sophiayduan/fallout-badges/hardware/3dmodels/2_7inch_e-paper_hat_asm.stp

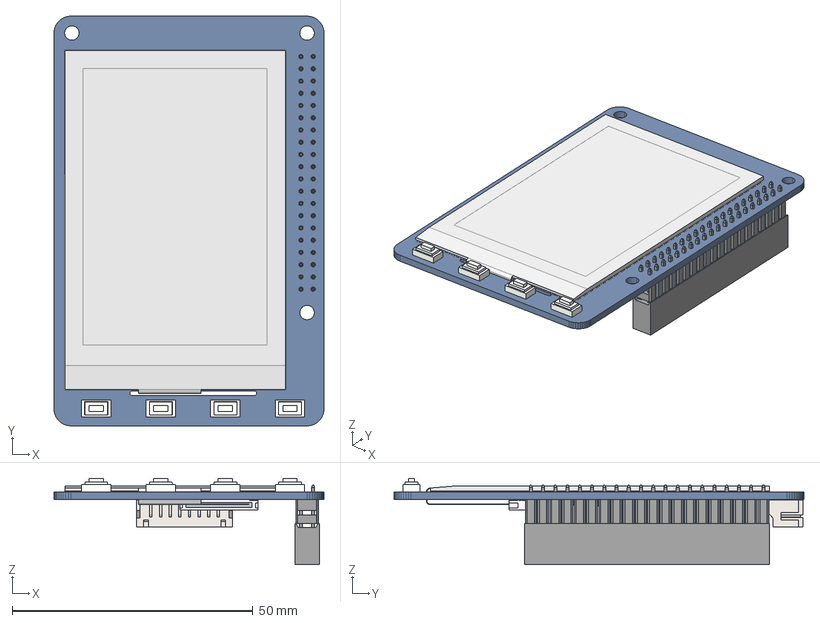
[picture p1: CAD file, 2026-06-06]
hardware/3dmodels/2_7inch_e-paper_hat_asm.stp
56.0 x 85.0 x 17.9 mm
2_7INCH-E_PAPER
BOARD
RESC1608_0603_ x 9
EXTRUDED-10550 x 6
EXTRUDED-10922
EXTRUDED-11344
ALSROBOT-SOT23
INDC3225_1210_
CIRCUITWORKS-SOD123 x 3
CAPC1608_0603_ x 17
SW3DPS-SOT-23-5-DEFAULT
USER_LIBRARY-TSSOP20_TP_BOARD1
USER_LIBRARY-TSSOP20_TP_EXTRUDE
USER_LIBRARY-TSSOP20_TP_TSSOP21
KEY x 4
HEADER-FPC-ZIF-SMD-HORIZO-34198
HEADER-FPC-ZIF-SMD-HORIZO-96117
FEMALE-2_54MM-H13_5-2X20P-V
HP2_0-8PIN-SMT-HORIZONTAL
0_2MM-3M
