sophiayduan/fallout-badges/hardware/3dmodels/2_7INCH-E_PAPER.step

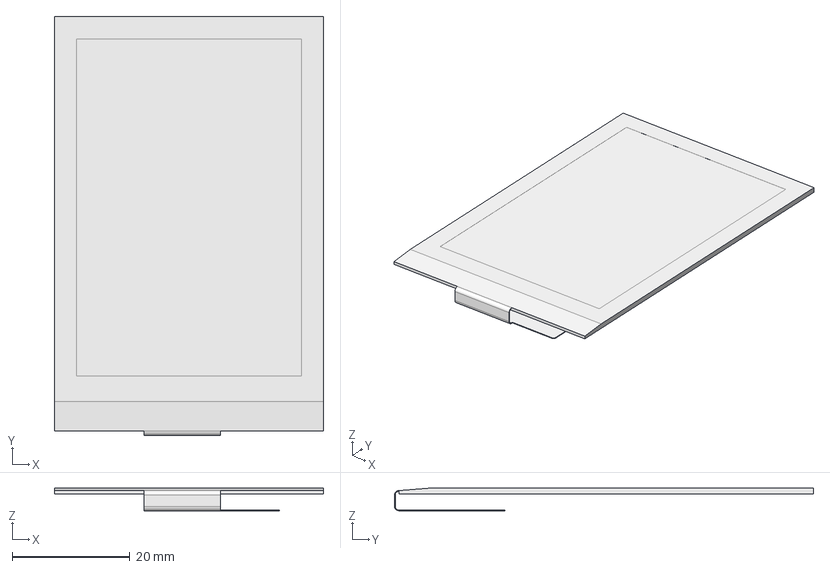
[picture p2: CAD file, 2026-06-08]
hardware/3dmodels/2_7INCH-E_PAPER.step
45.8 x 71.2 x 3.84 mm
