sophiayduan/fallout-badges/hardware/graphics/outline_new.dxf

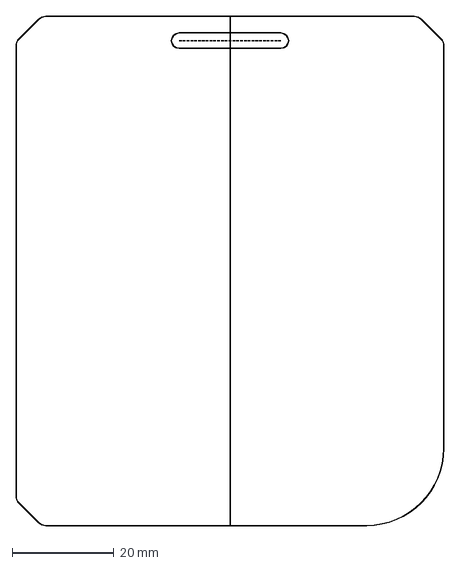
[picture p3: CAD file, 2026-06-06]
hardware/graphics/outline_new.dxf
84.0 x 100.0 mm
