sophiayduan/fallout-badges/hardware/3dmodels/SW-TH_4P-L12.0-W12.0-P5.00-LS12.5.step

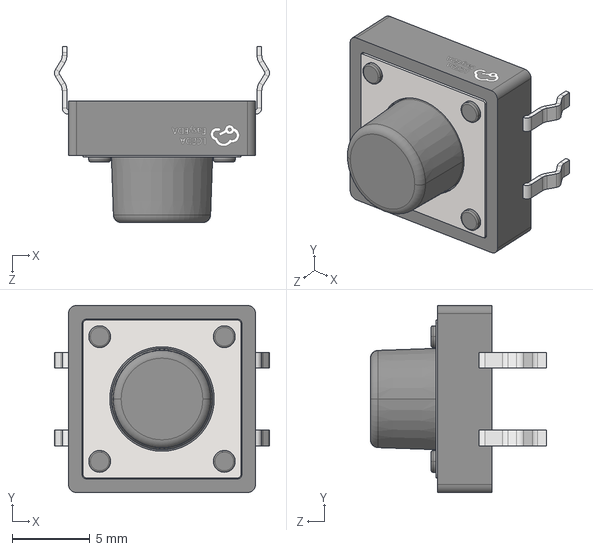
[picture p4: CAD file, 2026-06-07]
hardware/3dmodels/SW-TH_4P-L12.0-W12.0-P5.00-LS12.5.step
13.8 x 12.0 x 11.3 mm
