sophiayduan/fallout-badges/hardware/graphics/outline.dxf

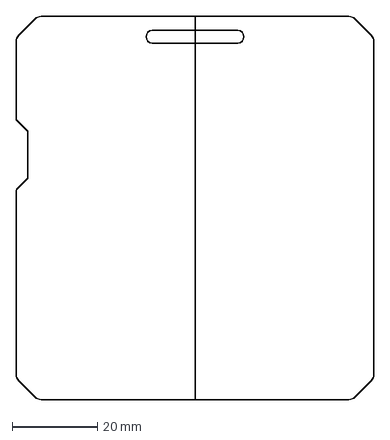
[picture p5: CAD file, 2026-05-31]
hardware/graphics/outline.dxf
84.0 x 90.0 mm
