sophiayduan/fallout-badges/hardware/3dmodels/SW-SMD_4P-L4.2-W3.3-H2.5-P2.15-LS4.6.step

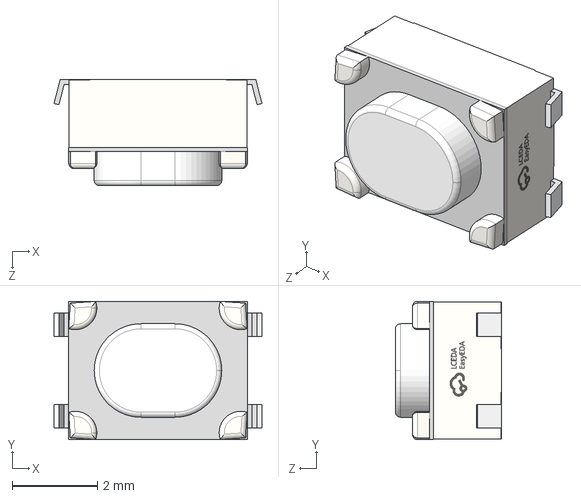
[picture p6: CAD file, 2026-06-06]
hardware/3dmodels/SW-SMD_4P-L4.2-W3.3-H2.5-P2.15-LS4.6.step
4.89 x 3.25 x 2.50 mm
