sophiayduan/fallout-badges/hardware/3dmodels/KEY-SMD_4P-L12.0-W12.0-H7.3-LS15.0-P5.0.step

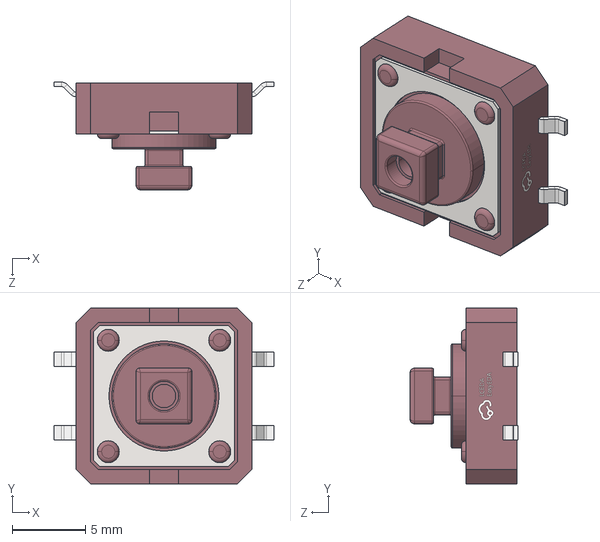
[picture p7: CAD file, 2026-06-06]
hardware/3dmodels/KEY-SMD_4P-L12.0-W12.0-H7.3-LS15.0-P5.0.step
15.0 x 12.0 x 7.35 mm
