sophiayduan/fallout-badges/hardware/3dmodels/SC-70-6_L2.0-W1.3-H1.0-P0.65.step

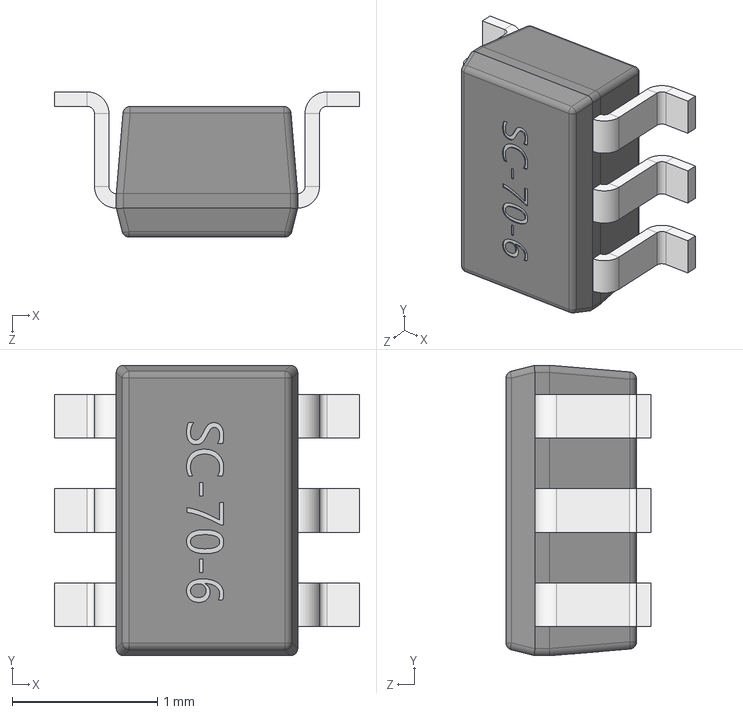
[picture p8: CAD file, 2026-05-31]
hardware/3dmodels/SC-70-6_L2.0-W1.3-H1.0-P0.65.step
2.10 x 2.00 x 1.00 mm
