sophiayduan/fallout-badges/hardware/3dmodels/NT3H2111W0FHKH.step

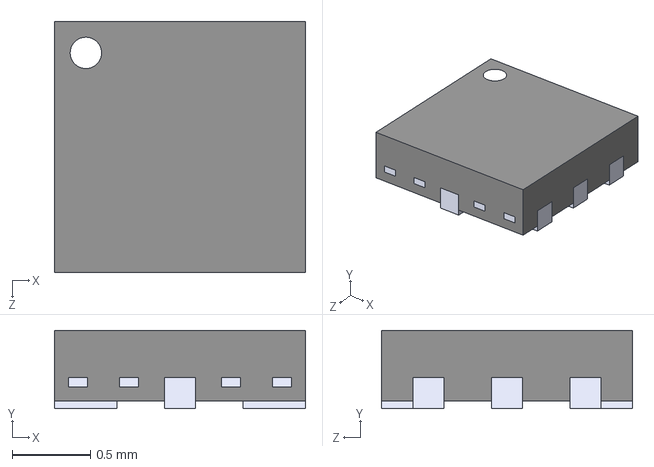
[picture p9: CAD file, 2026-05-31]
hardware/3dmodels/NT3H2111W0FHKH.step
1.60 x 0.5 x 1.60 mm
