sophiayduan/fallout-badges/hardware/3dmodels/Waveshare 2.13 (D) E-ink - Reverse Mount.stp

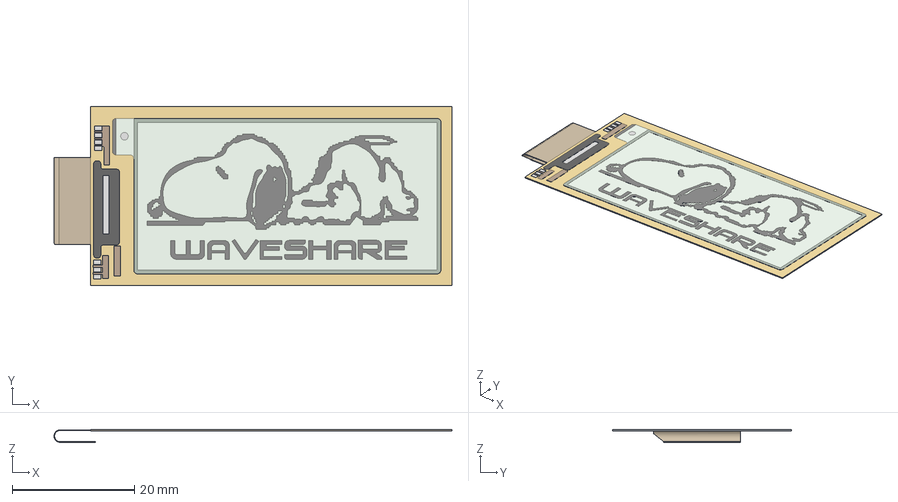
[picture p10: CAD file, 2026-05-31]
hardware/3dmodels/Waveshare 2.13 (D) E-ink - Reverse Mount.stp
65.1 x 29.2 x 2.17 mm
