sophiayduan/fallout-badges/hardware/3dmodels/GDEY027T91 v5.step

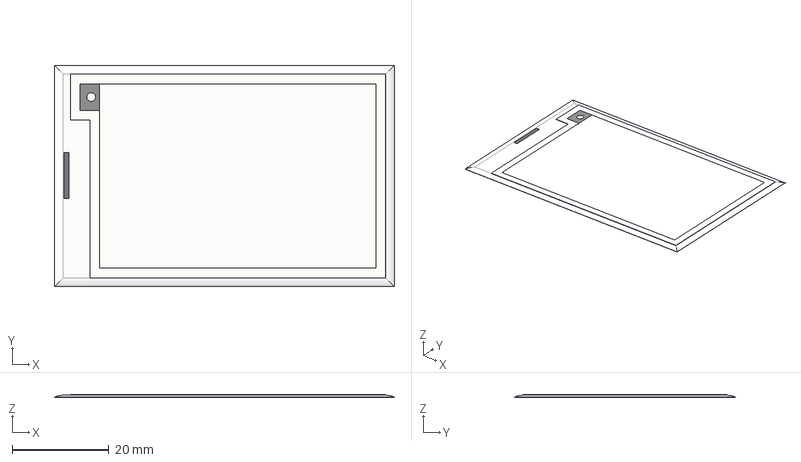
[picture p11: CAD file, 2026-05-31]
hardware/3dmodels/GDEY027T91 v5.step
70.4 x 45.8 x 0.55 mm
