sophiayduan/fallout-badges/hardware/3dmodels/Waveshare 2.9 E-ink - Display Folded Flush.stp

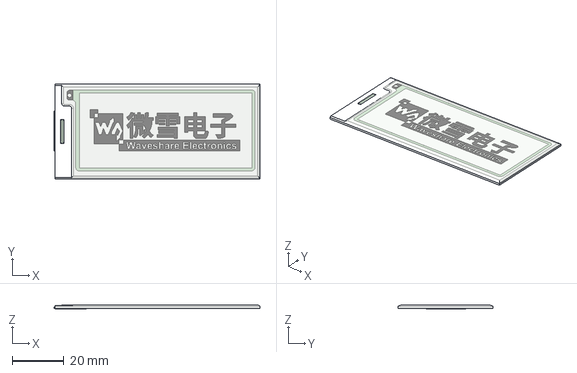
[picture p12: CAD file, 2026-05-31]
hardware/3dmodels/Waveshare 2.9 E-ink - Display Folded Flush.stp
79.5 x 36.8 x 1.41 mm
