sophiayduan/fallout-badges/hardware/falloutbadge.kicad_pcb

## KiCad design hardware/falloutbadge.kicad_pcb (2026-06-16)

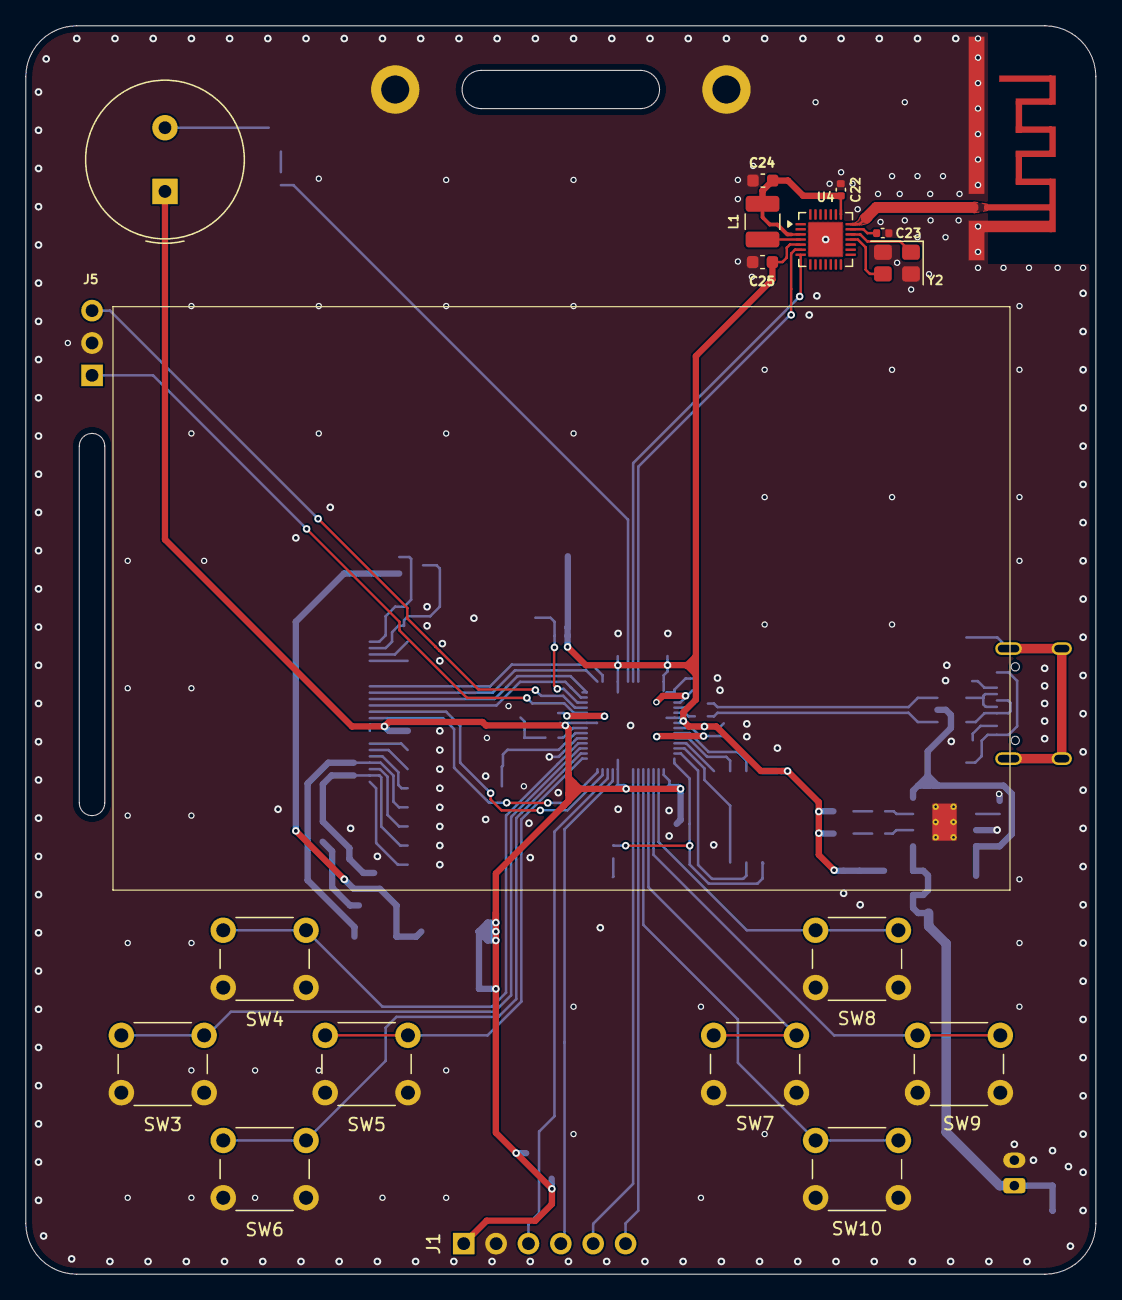
[picture p13: board falloutbadge.kicad_pcb from above]

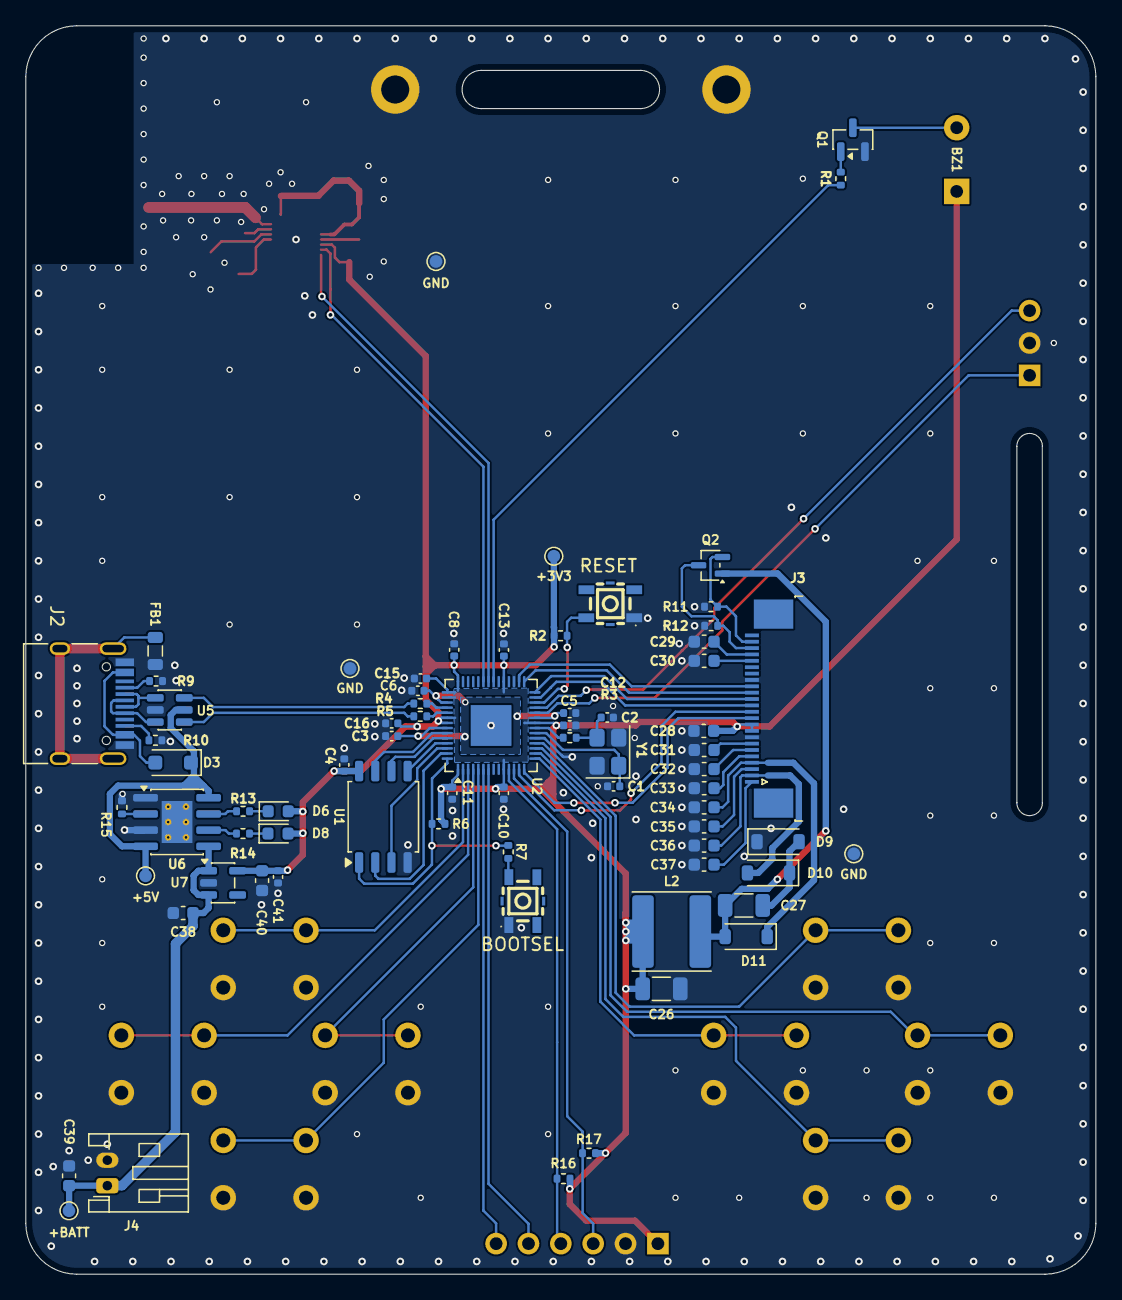
[picture p14: board falloutbadge.kicad_pcb from below]

Board: 2 copper layers, 84.0 x 98.0 mm, 93 parts (72 on the bottom side), 75 nets.

Parts:
+3V3: +3v3; TestPoint_Pad_D1.0mm
+5V: VBUS; TestPoint_Pad_D1.0mm
+BATT: +BATT; TestPoint_Pad_D1.0mm
AE2: Antenna_Shield; ANT-F-1-2.4G-1.6mmFR4-WCH
BOOTSEL: BOOTSEL; KEY-SMD_K2-1177SW-A4DW-06
BZ1: Buzzer; Buzzer_TDK_PS1240P02BT_D12.2mm_H6.5mm
C1, C2: 33pF; C_0402_1005Metric
C3, C4, C5, C10, C11, C12, C13, C15, C16, C22, C41: 100nF; C_0402_1005Metric
C6, C8: 1uF; C_0402_1005Metric
C23: 0.47uF; C_0402_1005Metric
C24, C38, C40: 4.7uF; C_0603_1608Metric
C25: 2.2uF; C_0603_1608Metric
C26, C27: 4.7uF; C_1206_3216Metric
C28, C29, C30, C31, C32, C33, C34, C35, C36, C37: 1uF; C_0603_1608Metric
C39: 10uF; C_0603_1608Metric
D3: D; D_SOD-123F
D6: RED; LED_0603_1608Metric
D8: NOT RED; LED_0603_1608Metric
D9, D10, D11: MBR0530; D_SOD-123
FB1: BLM18AG601SN1D; L_0805_2012Metric
GND: GND; TestPoint_Pad_D1.0mm
GND#2, GND#3: GND; TestPoint_Pad_D1.0mm
H1, H2: MountingHole; MountingHole_2.2mm_M2_DIN965_Pad
J1: Conn_02x03; PinHeader_1x06_P2.54mm_Vertical
J2: USB_C_Receptacle_USB2.0_16P; USB_C_Receptacle_HRO_TYPE-C-31-M-12
J3: E-INK; TE_2-1734839-4_1x24-1MP_P0.5mm_Horizontal
J4: LiPo; JST_PH_S2B-PH-K_1x02_P2.00mm_Horizontal
J5: Conn_01x03; PinHeader_1x03_P2.54mm_Vertical
L1: 10uH; L_1210_3225Metric
L2: 68uH; L_Changjiang_FNR6028S
Q1: AO3400A; SOT-23
Q2: Si1308EDL; SOT-323_SC-70
R1, R13, R14: 330R; R_0402_1005Metric
R2, R6, R11: 10k; R_0402_1005Metric
R3, R7: 1k; R_0402_1005Metric
R4, R5: 27.4R; R_0402_1005Metric
R9, R10: 5.1k; R_0402_1005Metric
R12: 0.47R; R_0402_1005Metric
R15: 2.2k; R_0402_1005Metric
R16, R17: 4k7; R_0402_1005Metric
RESET: RESET; KEY-SMD_K2-1177SW-A4DW-06
SW3, SW4, SW5, SW6, SW7, SW8, SW9, SW10: SW_Push; SW_PUSH_6mm
U1: W25Q32JVSS; SOIC-8_5.3x5.3mm_P1.27mm
U2: RP2040; QFN-56-1EP_7x7mm_P0.4mm_EP3.2x3.2mm
U4: CH592F; WQFN-28-1EP_4x4mm_P0.4mm_EP2.7x2.7mm
U5: USBLC6-2SC6; SOT-23-6
U6: TP4056-42-ESOP8; SOIC-8-1EP_3.9x4.9mm_P1.27mm_EP2.41x3.3mm_ThermalVias
U7: AP2112K-3.3; SOT-23-5
Y1: 12MHz; Crystal_SMD_3225-4Pin_3.2x2.5mm
Y2: 32MHz; Crystal_SMD_3225-4Pin_3.2x2.5mm

Connections:
+1V1: C3.1, C5.1, C6.1, U2.23 (DVDD), U2.45 (VREG_VOUT), U2.50 (DVDD)
+3V3: +3V3.1, BZ1.1 (+), C4.1, C8.1, C10.1, C11.1, C12.1, C13.1, C15.1, C16.1, C25.2, C26.1, C28.2, C40.2, C41.1, D6.2 (A), D8.2 (A), J1.1, J3.9, J3.10, L2.1, R2.1, R6.1, R16.1, R17.1, U1.8 (VCC), U2.1 (IOVDD), U2.10 (IOVDD), U2.22 (IOVDD), U2.33 (IOVDD), U2.42 (IOVDD), U2.43 (ADC_AVDD), U2.44 (VREG_VIN), U2.48 (USB_VDD), U2.49 (IOVDD), U4.5 (VDD33/VIO33), U7.5 (VOUT)
+BATT: +BATT.1, C38.2, C39.1, J4.1, U6.5 (BAT), U7.1 (VIN), U7.3 (EN)
/BTN1: SW3.1, U2.17 (GPIO14)
/BTN2: SW4.1, U2.18 (GPIO15)
/BTN3: SW5.1, U2.15 (GPIO12)
/BTN4: SW6.1, U2.16 (GPIO13)
/BTN5: SW7.1, U2.4 (GPIO2)
/BTN6: SW8.1, U2.2 (GPIO0)
/BTN7: SW9.1, U2.3 (GPIO1)
/BTN8: SW10.1, U2.5 (GPIO3)
/BUSY: J3.16, U2.30 (GPIO19)
/BUZ: R1.1, U2.35 (GPIO23)
/CS: J3.13, U2.27 (GPIO16)
/D+: R5.1, U5.4 (I/O2)
/D-: R4.1, U5.6 (I/O1)
/DC: J3.14, U2.28 (GPIO17)
/GDR: J3.23, Q2.2 (G), R11.1
/GPIO4: J1.6, U2.6 (GPIO4)
/GPIO5: J1.5, U2.7 (GPIO5)
/PREVGH: C34.2, D11.1 (K), J3.4
/PREVGL: C36.2, D10.2 (A), J3.2
/QSPI_SCK: U1.6 (CLK), U2.52 (QSPI_SCLK)
/QSPI_SD0: U1.5 (DI/IO_{0}), U2.53 (QSPI_SD0)
/QSPI_SD1: U1.2 (DO/IO_{1}), U2.55 (QSPI_SD1)
/QSPI_SD2: U1.3 (~WP/IO_{2}), U2.54 (QSPI_SD2)
/QSPI_SD3: U1.7 (~HOLD/~RESET/IO_{3}), U2.51 (QSPI_SD3)
/QSPI_SS: R6.2, R7.2, U1.1 (~CS), U2.56 (~QSPI_SS)
/RESE: J3.22, Q2.3 (S), R12.1
/RST: J3.15, U2.29 (GPIO18)
/SCL: J1.3, R17.2, U2.12 (GPIO9)
/SDA: J1.4, R16.2, U2.11 (GPIO8)
/SPI_MOSI: J3.11, U2.14 (GPIO11)
/SPI_SCK: J3.12, U2.13 (GPIO10)
/SWCLK: J5.1, U2.24 (SWCLK)
/SWDIO: J5.3, U2.25 (SWDIO)
/UART1_RX: U2.37 (GPIO25), U4.6 (PA8)
/UART1_TX: U2.36 (GPIO24), U4.7 (PA9)
/VDCIA: C22.2, C24.1, L1.2, U4.3 (VDCID), U4.22 (VDCIA)
/VSW: L1.1, U4.4 (VSW)
/X32MI: U4.19 (X32MI), Y2.1
/X32MO: U4.18 (~X32MO), Y2.3
GND: AE2.0 (Shield), BOOTSEL.1, C1.1, C2.1, C3.2, C4.2, C5.2, C6.2, C8.2, C10.2, C11.2, C12.2, C13.2, C15.2, C16.2, C22.1, C23.1, C24.2, C25.1, C26.2, C28.1, C29.1, C30.1, C31.1, C32.1, C33.1, C34.1, C35.1, C36.1, C37.1, C38.1, C39.2, C40.1, C41.2, D9.1 (K), FB1.2, GND.1, GND#2.1, GND#3.1, H1.1, H2.1, J1.2, J2.A1 (GND), J2.A12 (GND), J2.B1 (GND), J2.B12 (GND), J3.8, J3.17, J4.2, J5.2, Q1.2 (S), R9.2, R10.2, R11.2, R12.2, R15.2, RESET.1, SW3.2, SW4.2, SW5.2, SW6.2, SW7.2, SW8.2, SW9.2, SW10.2, U1.4 (GND), U2.19 (TESTEN), U2.31 (GPIO20), U2.57 (GND), U4.29 (GND), U5.2 (GND), U6.1 (TEMP), U6.3 (GND), U6.9 (EPAD), U7.2 (GND), Y1.2, Y1.4, Y2.2, Y2.4
unnamed: AE2.1 (A), U4.21 (ANT)
unnamed: BZ1.2 (-), Q1.3 (D)
unnamed: C2.2, R3.1, Y1.3
unnamed: D3.2 (A), J2.A4 (VBUS), J2.A9 (VBUS), J2.B4 (VBUS), J2.B9 (VBUS)
unnamed: D6.1 (K), R13.1
unnamed: D8.1 (K), R14.1
unnamed: C27.1, D9.2 (A), D10.1 (K)
unnamed: C27.2, D11.2 (A), L2.2, Q2.1 (D)
unnamed: J2.A5 (CC1), R9.1
unnamed: J2.B5 (CC2), R10.1
unnamed: J2.A6 (D+), J2.B6 (D+), U5.3 (I/O2)
unnamed: J2.A7 (D-), J2.B7 (D-), U5.1 (I/O1)
unnamed: FB1.1, J2.S1 (SHIELD)
unnamed: C37.2, J3.1
unnamed: C35.2, J3.3
unnamed: C33.2, J3.5
unnamed: C32.2, J3.6
unnamed: C31.2, J3.7
unnamed: C30.2, J3.20
unnamed: C29.2, J3.21
unnamed: Q1.1 (G), R1.2
unnamed: BOOTSEL.2, R7.1
unnamed: R2.2, RESET.2, U2.26 (RUN)
unnamed: R4.2, U2.46 (USB_DM)
unnamed: R5.2, U2.47 (USB_DP)
unnamed: C1.2, U2.20 (XIN), Y1.1
unnamed: R3.2, U2.21 (XOUT)
unnamed: C23.2, U4.20 (VINTA)
unnamed: R15.1, U6.2 (PROG)
unnamed: R13.2, U6.7 (~CHRG)
unnamed: R14.2, U6.6 (~STDBY)
VBUS: +5V.1, D3.1 (K), U5.5 (VBUS), U6.4 (V_{CC}), U6.8 (CE)
