sophiayduan/fallout-badges/(commit log)

2026-05-01 add kicad files
    [falloutbadge.kicad_pcb, falloutbadge.kicad_sch]
2026-05-21 Add .gitignore for KiCad project files
2026-05-31 schematic with stm32
    [GDEY027T91 v5.step, LED-SMD_4P-L4.0-W1.6-L.step, NT3H2111W0FHKH.step, SC-70-6_L2.0-W1.3-H1.0-P0.65.step, Waveshare 2.13 (D) E-ink - Reverse Mount.stp, Waveshare 2.9 E-ink - Display Folded Flush.stp, falloutbadge.kicad_sch, ledblock.kicad_sch]
2026-06-06 vddrf1v5 and smps, + uart fix
    [falloutbadge.kicad_sch]
2026-06-06 update pcb and improve power path
    [falloutbadge.kicad_pcb]
2026-06-06 stitching vias + drc
    [falloutbadge.kicad_pcb]
2026-06-07 final fixes
    [SW-TH_4P-L12.0-W12.0-P5.00-LS12.5.step, bom.csv, designators.csv, falloutbadge.csv, falloutbadge.kicad_pcb, falloutbadge.kicad_sch, ledblock.kicad_sch, positions.csv]
2026-06-08 assign lcsc parts and flip eink
    [2_7INCH-E_PAPER.step, bom.csv, falloutbadge.kicad_pcb, falloutbadge.kicad_sch, positions.csv]
2026-06-12 add v2 w/o lora
    [bom.csv, designators.csv, falloutbadge.csv, falloutbadge.kicad_pcb, falloutbadge.kicad_sch, ledblock.kicad_sch, positions.csv]
2026-06-16 final board for prod
    [bom.csv, designators.csv, falloutbadge.kicad_pcb, falloutbadge.kicad_sch, positions.csv]
2026-06-21 add max's code + new 2.7" epd driver
2026-06-25 add print statement
